jojo082708/puren_game_2026/load_arm_v2/README.md

# 承重桿治具 v3（馬達系統鑑別用）

正式版在 **`cad/`**（text-to-cad / build123d B-rep 模型，可編輯 STEP）。
`archive_v2_mesh/` 是舊的網格版（v2），**已停用，請勿列印**。

## 零件（`cad/STEP`、`cad/STL`、`cad/3MF`）

| 檔名 | 零件 | 數量 |
|---|---|---|
| `load_arm_ak70` | 承重桿（AK70-9 用）：Ø29 定心凸台 + Ø19.7 導正凸緣、6×M3 沉頭、3×Ø3 定位銷孔 | 1（擇一） |
| `load_arm_ak60` | 承重桿（AK60-39 V3.0 用）：Ø38 凸台、3×M4 沉頭、3×Ø4 定位銷孔 | 1（擇一） |
| `load_pin_Tr24.5x3` | 承重軸：Tr24.5×3 螺紋長 170，帶 D 形切面（距軸心 11.0） | 1 |
| `clamp_plate_80x5_keyed` | 壓板 Ø80×5，D 形內孔卡住承重軸，不會跟著轉 | 1 |
| `star_knob_Tr24.5x3` | 星形旋鈕螺母 Ø70×24 | 1 |
| `lock_knob_Tr24.5x3` | 星形鎖緊旋鈕 Ø70×12（雙螺帽防鬆） | 1 |

P1–P5 力臂：100 / 150 / 200 / 250 / 300 mm。

## 標準件

| 品項 | 規格 | 數量 |
|---|---|---|
| 全牙螺桿 | M12，8.8 級，長 240 | 1 |
| 六角螺帽 | M12 | 2 |
| 大墊片（桿件底面） | DIN 9021 M12：Ø37 × Ø13 × 3 | 1 |
| 小墊片（承重軸頂端） | DIN 433 M12：Ø20 × Ø13 × 2 | 1 |
| AK70 用 | M3×12 內六角螺絲 ×6（原廠 STEP：M3 貫穿 6.7，咬入 4）、Ø3×8 定位銷 ×3（STEP：Ø3 深 3） | |
| AK60 用 | M4×12 內六角螺絲 ×3（原廠圖：M4 深 4，咬入 3.5）、Ø4×8 定位銷 ×3（原廠圖：Ø4 +0.02/0 深 3.5） | |

## 組裝順序

1. 承重桿用定位銷對正，鎖到馬達輸出盤上。
2. 承重軸鎖入要用的孔位（P1–P5），法蘭貼平桿件。
3. 從下方穿 M12 螺桿：底面 **DIN 9021 大墊片** + 螺帽；頂端 DIN 433 小墊片 + 螺帽，鎖緊（扭矩待驗證，建議先 ≤ 8 N·m，避免壓壞 PETG）。
4. 套槓片 → 壓板（D 形孔對準切面）→ 星形旋鈕鎖緊 → 鎖緊旋鈕往下鎖、頂住旋鈕。

## 驗證（`cad/check_fit.py`）

組合件內零件兩兩無干涉；M12 夾緊路徑、槓片堆疊逐一接觸；壓板轉 2° 即撞到 D 切面（確實止轉）；
與兩顆馬達原廠 STEP 比對：只接觸會轉的輸出盤，與固定外殼至少保持 1.27 mm。
原廠 STEP 請放在 `cad/vendor/`（不納入版本控制）。
