jojo082708/puren_game_2026/load_arm_v2/cad/STEP/load_arm_assembly_ak70.step

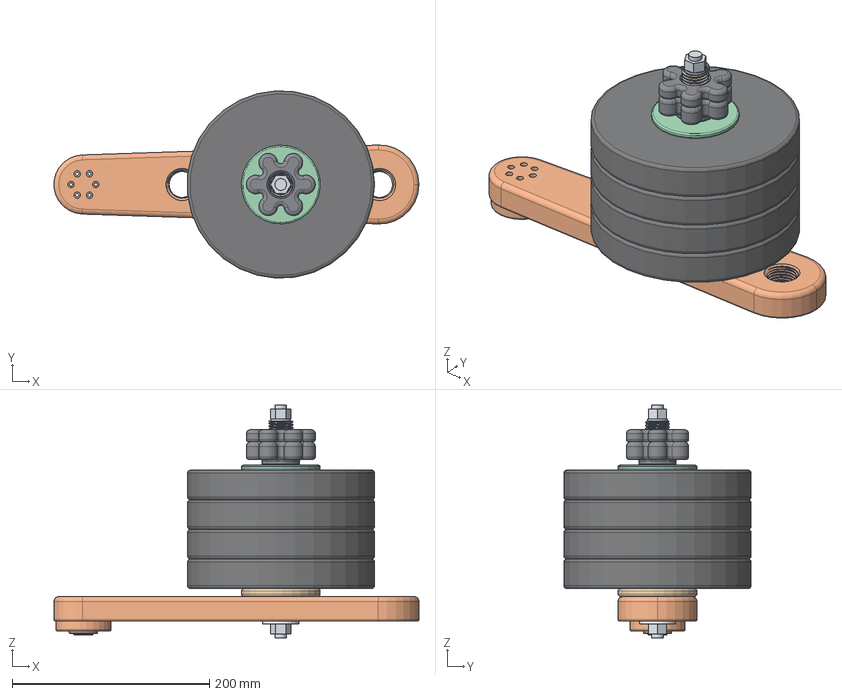
[picture p1: CAD file, 2026-11-04]
load_arm_v2/cad/STEP/load_arm_assembly_ak70.step
369.8 x 189.8 x 236.0 mm
load_arm_ak70
load_pin
weight_plate x 4
clamp_plate
star_knob
lock_knob
m12_rod
washer_din9021
washer_din433
m12_nut x 2
