jojo082708/puren_game_2026/load_arm_v2/load_arm_multi_hole.stl

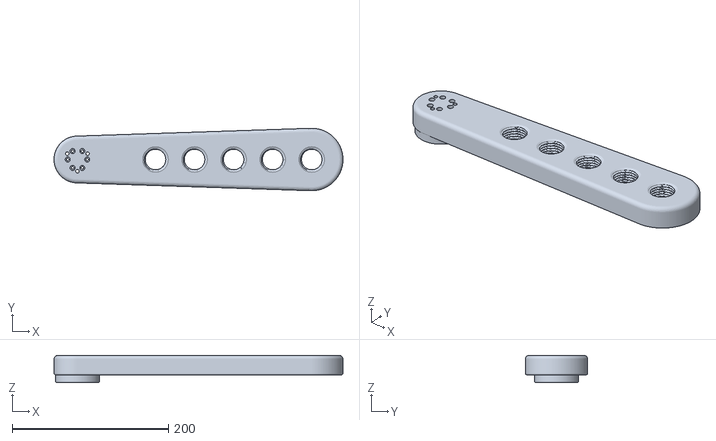
[picture p2: CAD file, 2026-10-31]
load_arm_v2/load_arm_multi_hole.stl
370.0 x 80.0 x 35.0
