jojo082708/puren_game_2026/load_arm_v2/cad/STEP/load_arm_ak60.step

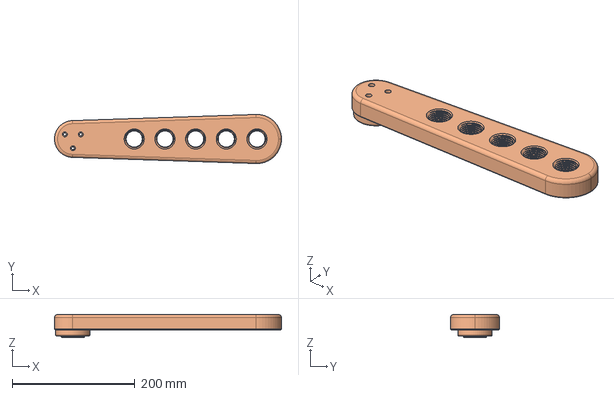
[picture p3: CAD file, 2026-11-04]
load_arm_v2/cad/STEP/load_arm_ak60.step
369.9 x 80.0 x 37.5 mm
