jojo082708/puren_game_2026/load_arm_v2/clamp_plate_80x5.stl

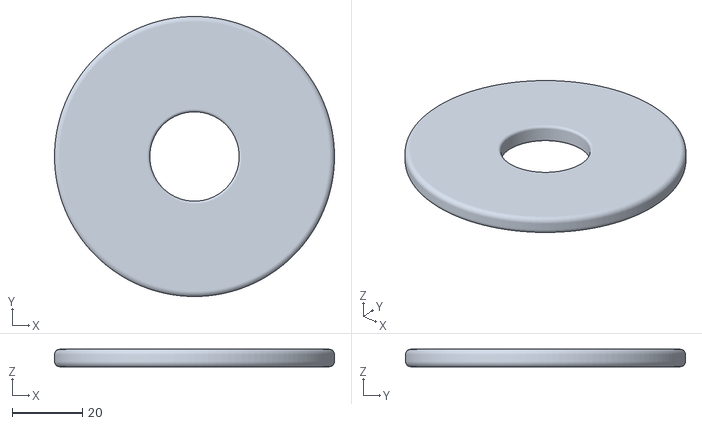
[picture p4: CAD file, 2026-10-31]
load_arm_v2/clamp_plate_80x5.stl
80.0 x 80.0 x 5.00
