jojo082708/puren_game_2026/load_arm_v2/cad/STEP/load_arm_ak70.step

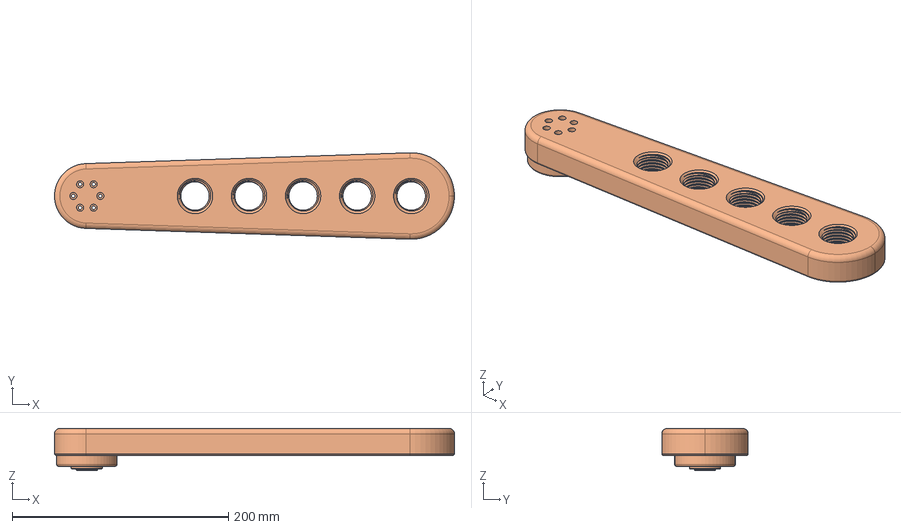
[picture p5: CAD file, 2026-11-04]
load_arm_v2/cad/STEP/load_arm_ak70.step
369.9 x 80.0 x 39.0 mm
