jojo082708/puren_game_2026/load_arm_v2/cad/STEP/lock_knob_Tr24.5x3.step

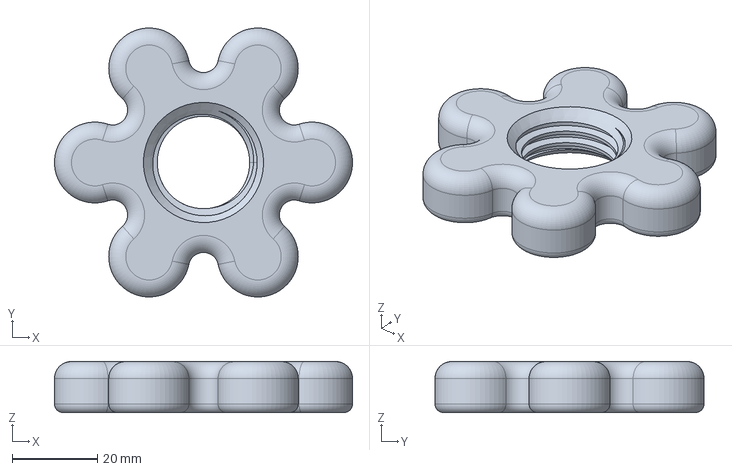
[picture p6: CAD file, 2026-11-04]
load_arm_v2/cad/STEP/lock_knob_Tr24.5x3.step
70.0 x 63.2 x 12.0 mm
