jojo082708/puren_game_2026/load_arm_v2/cad/STEP/load_pin_Tr24.5x3.step

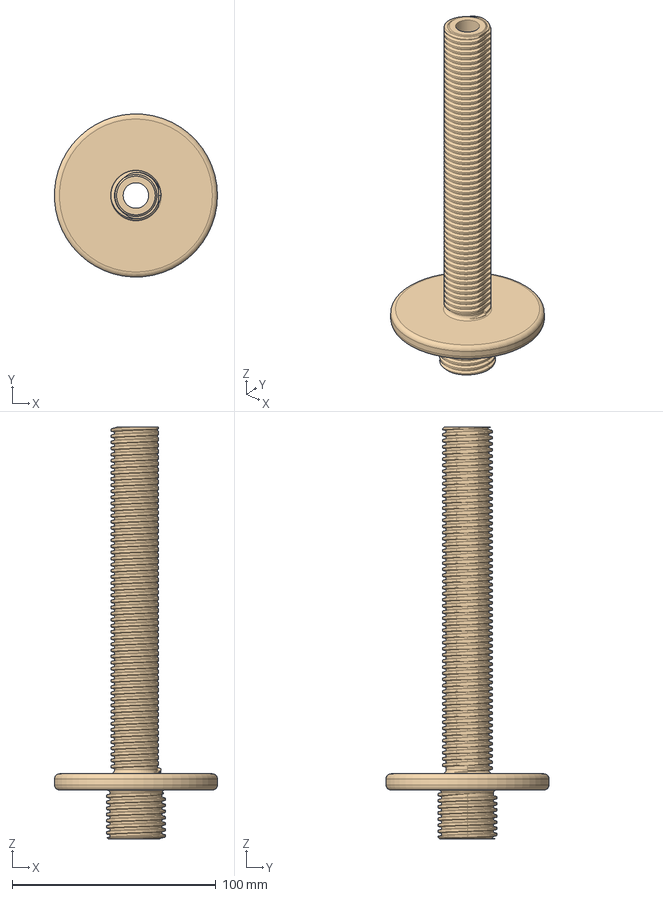
[picture p8: CAD file, 2026-11-04]
load_arm_v2/cad/STEP/load_pin_Tr24.5x3.step
79.9 x 80.0 x 202.0 mm
