jojo082708/puren_game_2026/load_arm_v2/archive_v2_mesh/star_knob_Tr24.5x3.stl

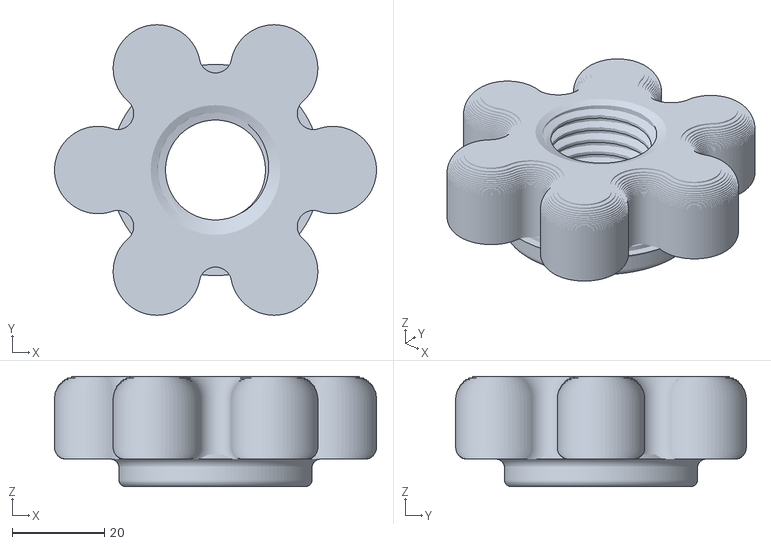
[picture p9: CAD file, 2026-10-31, an earlier design]
load_arm_v2/archive_v2_mesh/star_knob_Tr24.5x3.stl
70.0 x 63.2 x 24.0
