jojo082708/puren_game_2026/load_arm_v2/archive_v2_mesh/load_pin_Tr24.5x3.stl

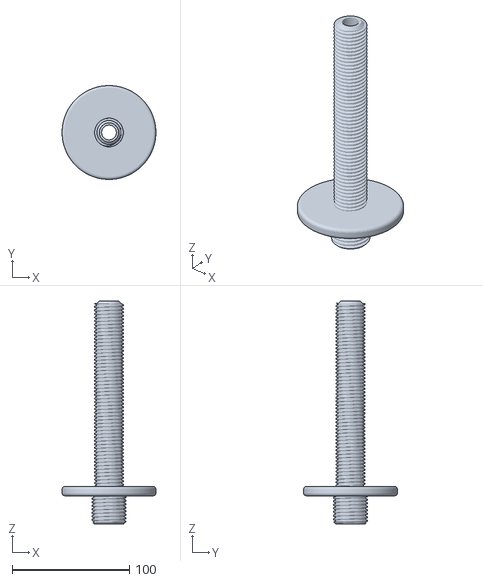
[picture p10: CAD file, 2026-10-31, an earlier design]
load_arm_v2/archive_v2_mesh/load_pin_Tr24.5x3.stl
80.0 x 80.0 x 190.0
