jojo082708/puren_game_2026/(list of files, cad)

Other CAD files:
load_arm_v2/cad/STEP/load_arm_assembly_ak60.step
load_arm_v2/cad/STEP/clamp_plate_80x5_keyed.step
load_arm_v2/cad/3MF/clamp_plate_80x5_keyed.3mf
load_arm_v2/cad/3MF/load_arm_ak60.3mf
load_arm_v2/cad/3MF/load_arm_ak70.3mf
load_arm_v2/cad/3MF/load_pin_Tr24.5x3.3mf
load_arm_v2/cad/3MF/lock_knob_Tr24.5x3.3mf
load_arm_v2/cad/3MF/star_knob_Tr24.5x3.3mf
load_arm_v2/cad/STL/clamp_plate_80x5_keyed.stl
load_arm_v2/cad/STL/load_arm_ak60.stl
load_arm_v2/cad/STL/load_arm_ak70.stl
load_arm_v2/cad/STL/load_pin_Tr24.5x3.stl
load_arm_v2/cad/STL/lock_knob_Tr24.5x3.stl
load_arm_v2/cad/STL/star_knob_Tr24.5x3.stl
