jojo082708/puren_game_2026/(commit log)

2026-06-09 Add 捷運解謎冒險.html — Taipei MRT mystery puzzle game
    Single-file HTML/CSS/JS adventure game featuring:
    - Title screen with animated MRT line background
    - Story intro briefing
    - Interactive game screen with schematic MRT map (SVG)
    - 5 stations: 台北車站, 西門, 龍山寺, 忠孝復興, 大安森林公園
    - 4 puzzles: Fibonacci sequence, age algebra, multi-step arithmetic, combinatorics
    - Inventory system tracking collected clues
    - Progress bar and win screen with attempt statistics
    - Hint system (shown after 3 wrong attempts)
    - Responsive layout for mobile
    https://claude.ai/code/session_012BF7mmF1nPCxrS7MHDJo2P
2026-10-31 Add load arm v2: multi-radius sockets, Tr24.5x3 pin, hex nut, clamp plate
    Claude-Session: https://claude.ai/code/session_012w1y5Wba9ttjNGZnrHBMPM
    [clamp_plate_80x5.stl, hex_nut_Tr24.5x3.stl, load_arm_multi_hole.stl, load_pin_Tr24.5x3.stl]
2026-10-31 Use real weight-plate size (1.5 kg, Ø190 x 30) in assembly drawing
    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
2026-10-31 Add fillets and rounded edges to all load-arm v2 parts
    Arm outline R5 top / R2 bottom, hub R1.5, flange R2.5, concave root
    fillets on shaft (R2) and spigot (R1.5), hex nut corners R3, clamp
    plate R1.5/R0.8. Drawings updated to match.
    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
    [clamp_plate_80x5.stl, hex_nut_Tr24.5x3.stl, load_arm_multi_hole.stl, load_pin_Tr24.5x3.stl]
2026-10-31 Replace hex nut with 6-lobe star knob nut (Ø70 x 24, Tr24.5x3)
    Hand-tightened knob with rounded lobes, R3.5 finger valleys, domed R5
    top edge and a Ø42 clamping boss. Drawings and README updated.
    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
    [hex_nut_Tr24.5x3.stl, star_knob_Tr24.5x3.stl]
2026-10-31 Add text-to-cad (build123d B-rep) version with editable STEP files
    Parts and assembly modelled as cadgen @model scripts: multi-hole arm,
    Tr24.5x3 pin, star knob nut, clamp plate. Real Tr threads via
    bd_warehouse; assembly threads phase-aligned, fit check shows zero
    interference. Exports STEP, STL, 3MF and GLB.
    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
    [clamp_plate_80x5.3mf, clamp_plate_80x5.step, clamp_plate_80x5.stl, load_arm_assembly.step, load_arm_multi_hole.3mf, load_arm_multi_hole.step, load_arm_multi_hole.stl, load_pin_Tr24.5x3.3mf]
2026-11-04 Load arm v3 (WIP): motor-specific arms, keyed clamp, lock knob, M12 washer
    - Split the arm into AK70 / AK60 variants measured against CubeMars STEP
    files: contact boss so the hub clears the stationary housing (was 0.5 mm),
    AK70 pilot spigot, dowel holes, per-motor counterbores.
    - Pin: shaft 170 mm with a D-flat; clamp plate keyed to it; thin lock knob.
    - Assembly: DIN 9021 washer under the arm so the M12 clamps arm and pin.
    - Archive the v2 mesh version; README rewritten for v3.
    Fit check and STEP/STL re-export still running; cad/STEP and cad/STL pin
    and knob files are not yet regenerated.
    Claude-Session: https://claude.ai/code/se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
    [clamp_plate_80x5.3mf, clamp_plate_80x5.step, clamp_plate_80x5.stl, load_arm_assembly.step, load_arm_multi_hole.3mf, load_arm_multi_hole.step, load_arm_multi_hole.stl, load_pin_Tr24.5x3.stl]
2026-11-04 Tighten keyed clamp plate to 0.2 mm (about 2.2 deg free turn)
    The 0.3 mm D-bore let the plate turn about 3.4 deg before touching the
    flat, so the 2 deg key check failed. With 0.2 mm the plate stops at about
    2 deg; check_fit now turns it 4 deg and requires contact.
    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
2026-11-04 Load arm v3: regenerate STEP, 3MF, GLB and 0.01 mm STL deliverables
    Fit check (cad/check_fit.py) passes: clamp path and plate stack touch
    with zero overlap, clamp plate keyed to the D-flat, and against the
    CubeMars STEP files the arm touches only the rotating output (housing
    clearance AK70 1.27 mm, AK60 1.64 mm; was 0.5 mm).
    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
    [clamp_plate_80x5_keyed.3mf, clamp_plate_80x5_keyed.step, clamp_plate_80x5_keyed.stl, load_arm_ak60.3mf, load_arm_ak60.step, load_arm_ak60.stl, load_arm_ak70.3mf, load_arm_ak70.step]
2026-11-04 Update cad README for v3
    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
2026-11-04 AK60 arm: size screws and dowels to the CubeMars 2D drawing
    The AK60-39 V3.0 2D drawing gives 3-M4 depth 4 and 3-Ø4 +0.02/0 depth 3.5
    on the output (the STEP models both 1.5 deep). Counterbore floor now 8.5 mm
    above the contact face, so M4x12 engages 3.5 mm and stops 0.5 mm short of
    the hole bottom; dowels Ø4x8. README BOM updated for both motors.
    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
    [load_arm_ak60.3mf, load_arm_ak60.step, load_arm_ak60.stl, load_arm_ak70.step, load_arm_assembly_ak60.step, load_arm_assembly_ak70.step]
